impatrq/ARES/Hardware/PCB/Placa_filtro/Filtro_3D.png

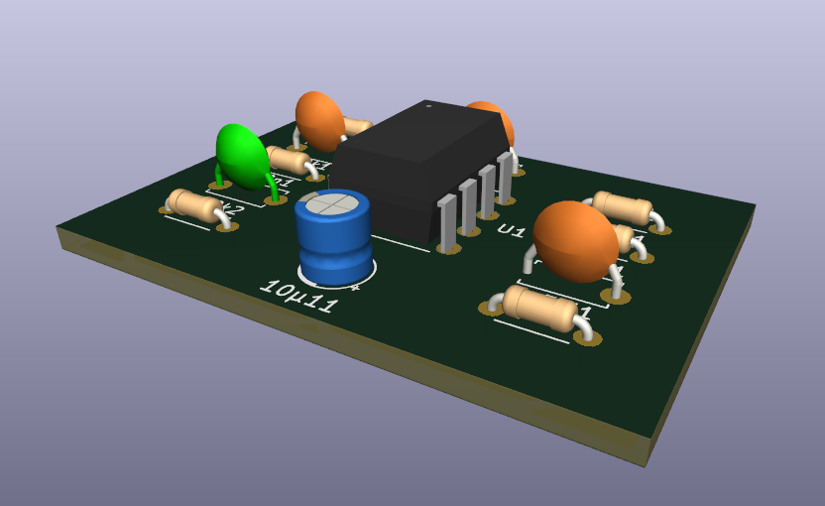
Hardware/PCB/Placa_filtro/Filtro_3D.png
