impatrq/ARES/Hardware/PCB/Placa_prototipo/Placa_prototipo.png

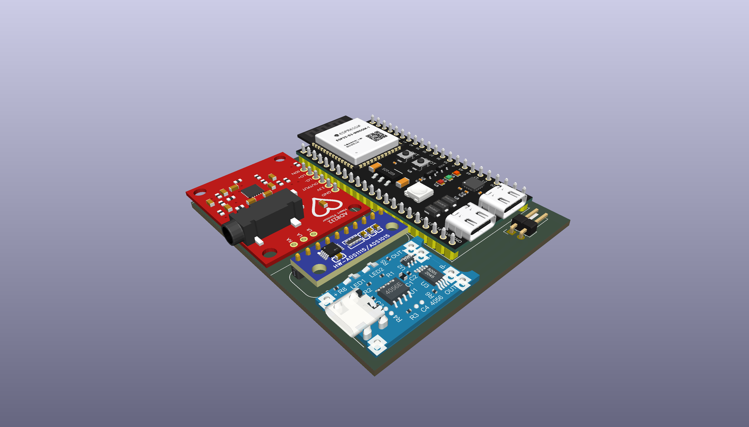
Hardware/PCB/Placa_prototipo/Placa_prototipo.png
