impatrq/ARES/Hardware/Diseño_3D/Diseño_Preliminar/Diseño_Preliminar.png

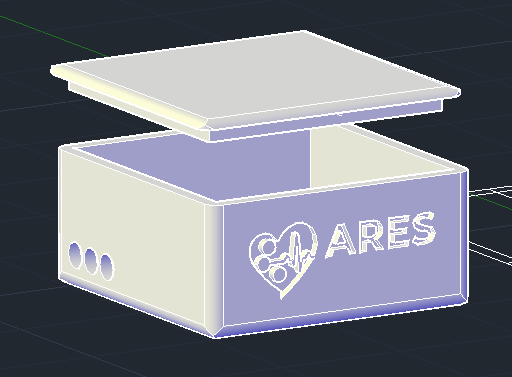
Hardware/Diseño_3D/Diseño_Preliminar/Diseño_Preliminar.png
