impatrq/ARES/Hardware/PCB/Placa_filtro/Placa_3D.png

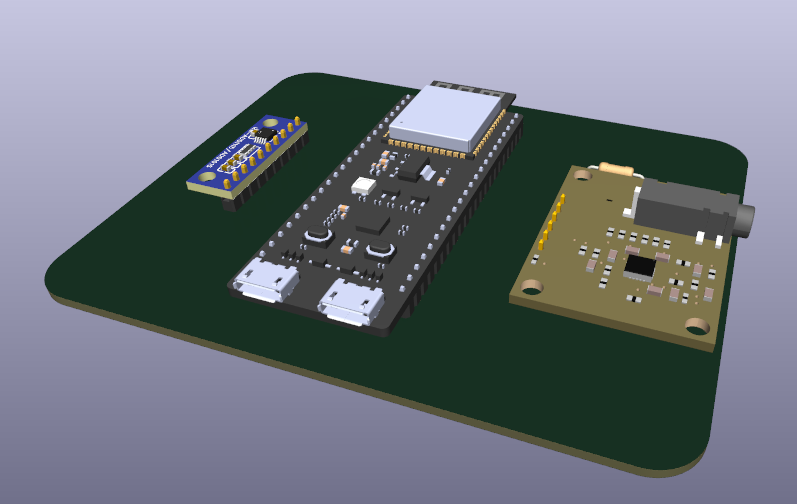
Hardware/PCB/Placa_filtro/Placa_3D.png
