impatrq/ARES/Hardware/PCB/Placa_filtro/Placa_Filtro.png

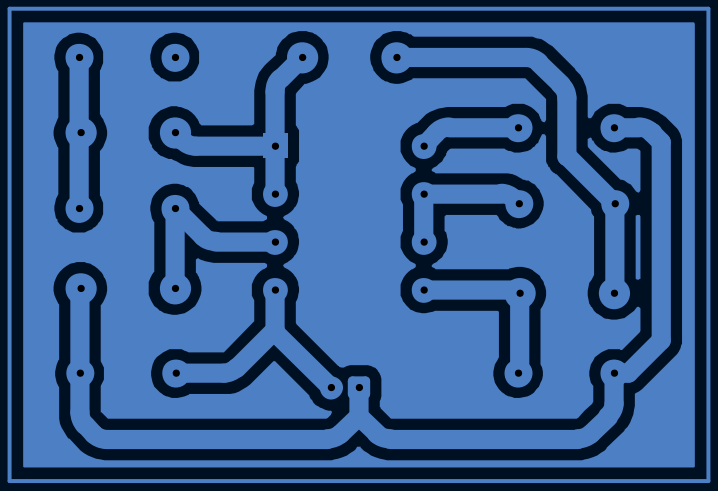
Hardware/PCB/Placa_filtro/Placa_Filtro.png
