impatrq/ARES/Simulaciones/Filtros/circuito filtros.jpeg

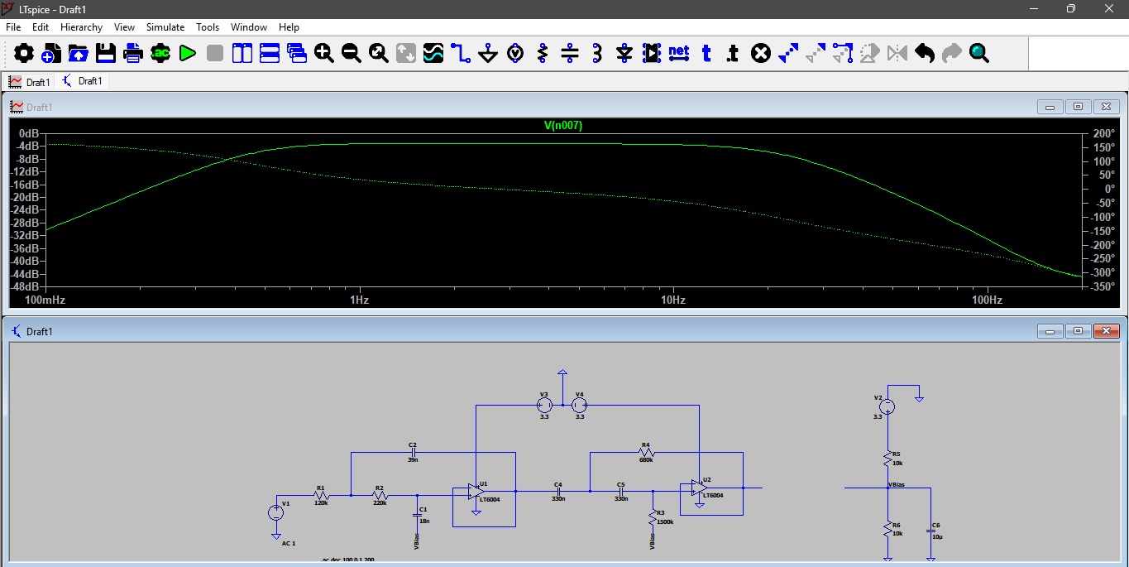
Simulaciones/Filtros/circuito filtros.jpeg
