impatrq/ARES/Web/web_vieja/src/assets/device-mockup.jpg

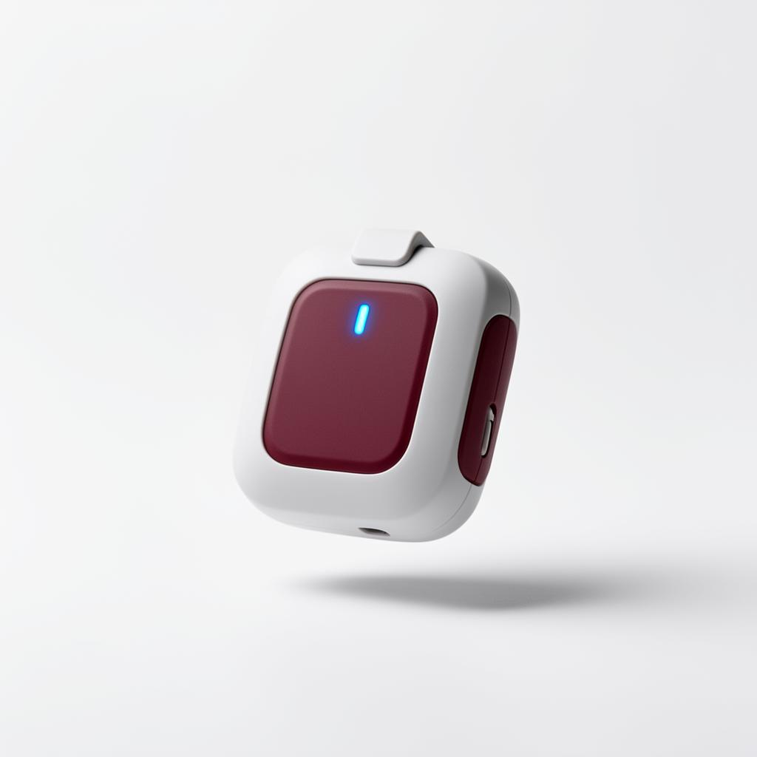
Web/web_vieja/src/assets/device-mockup.jpg
