impatrq/ARES/Web/web_vieja/src/assets/hero-bg.jpg

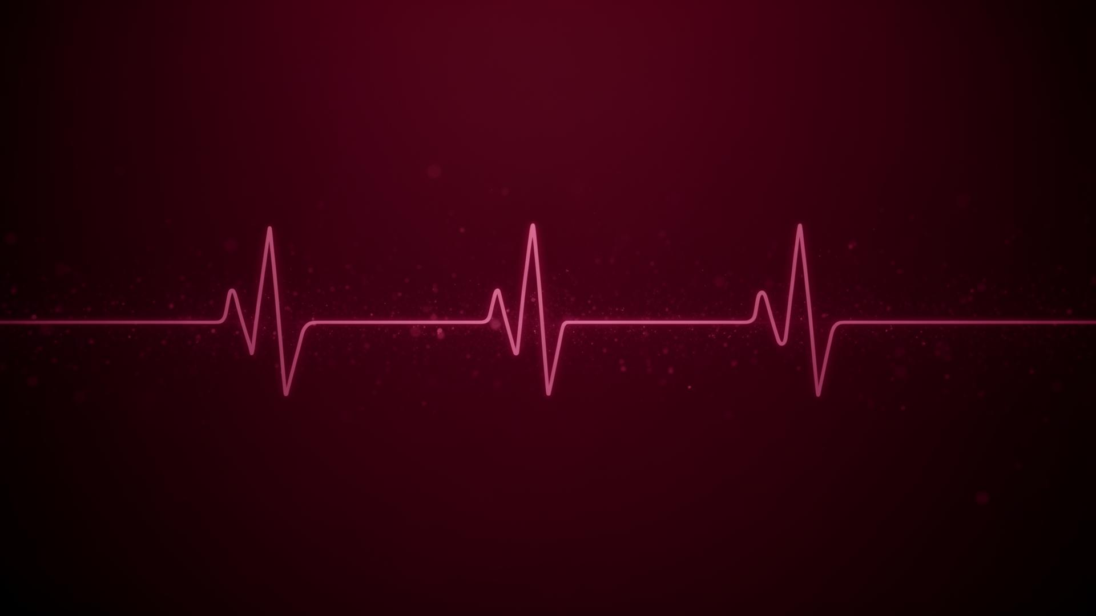
Web/web_vieja/src/assets/hero-bg.jpg
