impatrq/ARES/Hardware/Componentes/AD8232/AD8232_IC.jpg

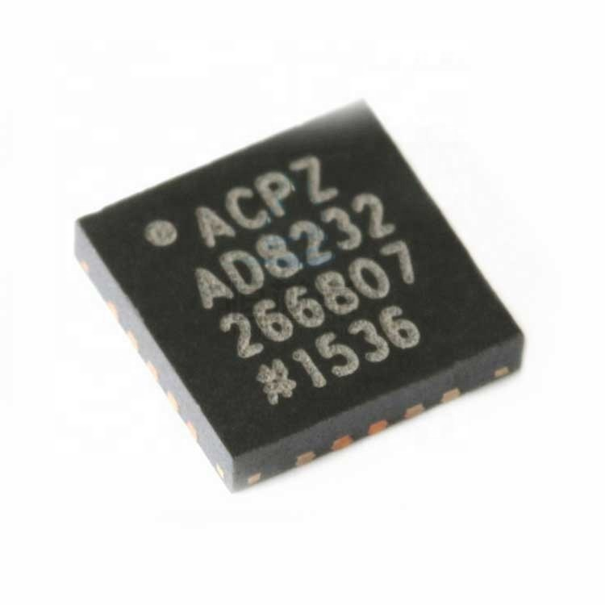
Hardware/Componentes/AD8232/AD8232_IC.jpg
