impatrq/ARES/Hardware/Componentes/AD8232/AD8232_modulo.jpg

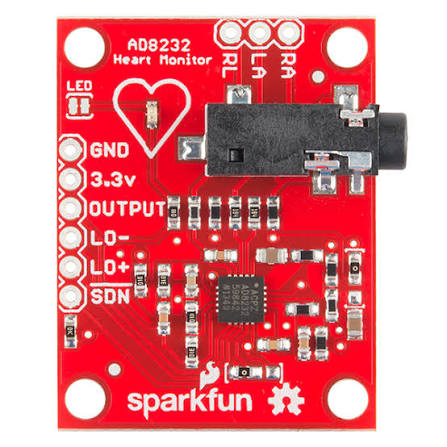
Hardware/Componentes/AD8232/AD8232_modulo.jpg
