impatrq/ARES/Hardware/Componentes/ADS1115/ADS1115_IC.png

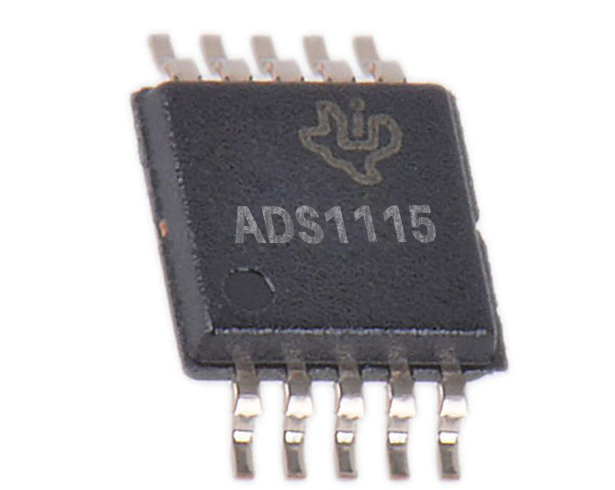
Hardware/Componentes/ADS1115/ADS1115_IC.png
