impatrq/ARES/Hardware/Componentes/ADS1115/ADS1115_modulo.jpg

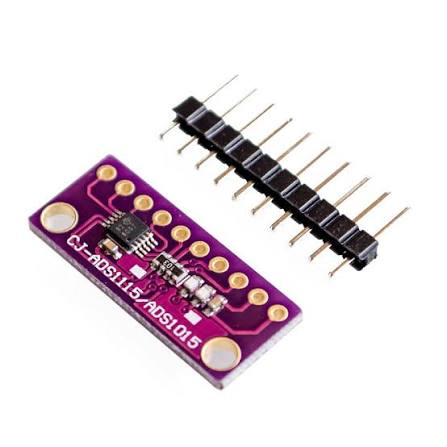
Hardware/Componentes/ADS1115/ADS1115_modulo.jpg
