impatrq/ARES/Hardware/Componentes/ESP32-S3/ESP32_S3_devkit.png

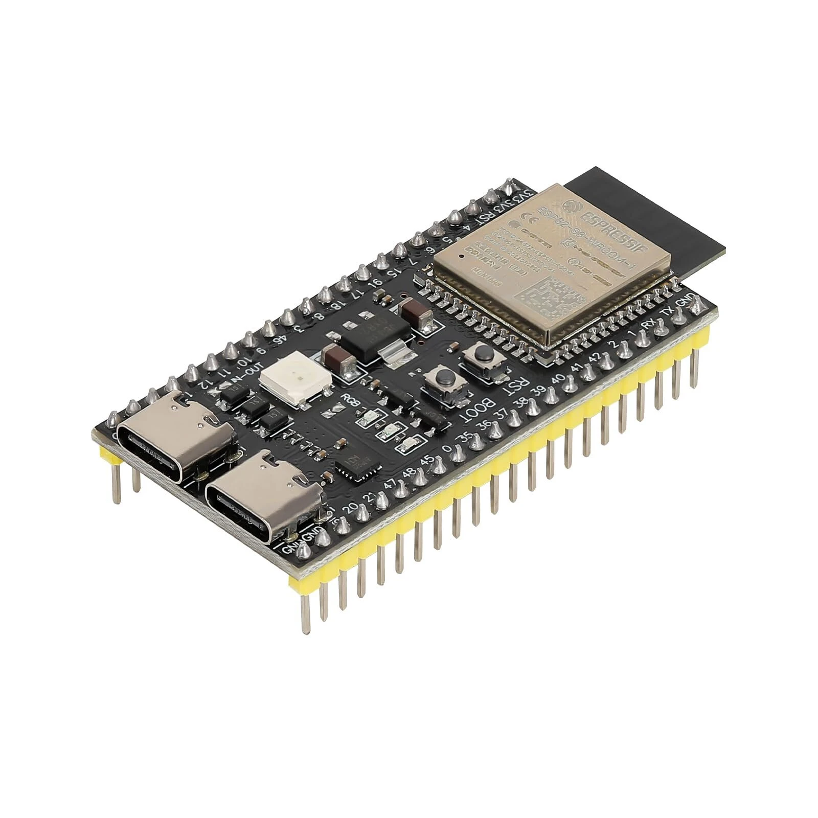
Hardware/Componentes/ESP32-S3/ESP32_S3_devkit.png
