impatrq/ARES/Hardware/Componentes/ESP32-S3/ESP32_S3_wroom.jpg

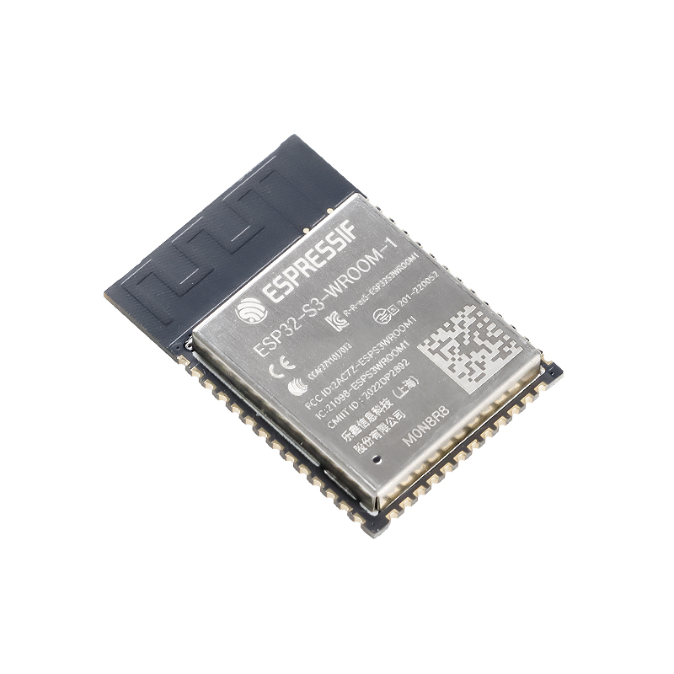
Hardware/Componentes/ESP32-S3/ESP32_S3_wroom.jpg
