impatrq/ARES/Hardware/Componentes/TP4056/TP4056_IC.jpg

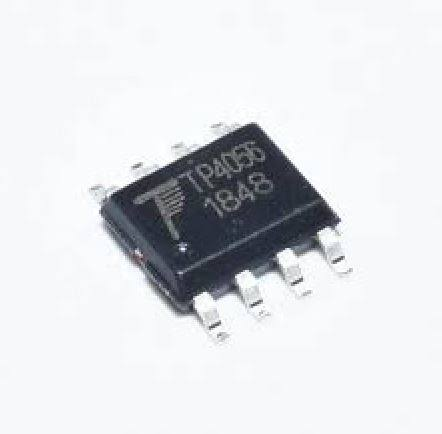
Hardware/Componentes/TP4056/TP4056_IC.jpg
