impatrq/ARES/Hardware/Componentes/TP4056/TP4056_modulo.png

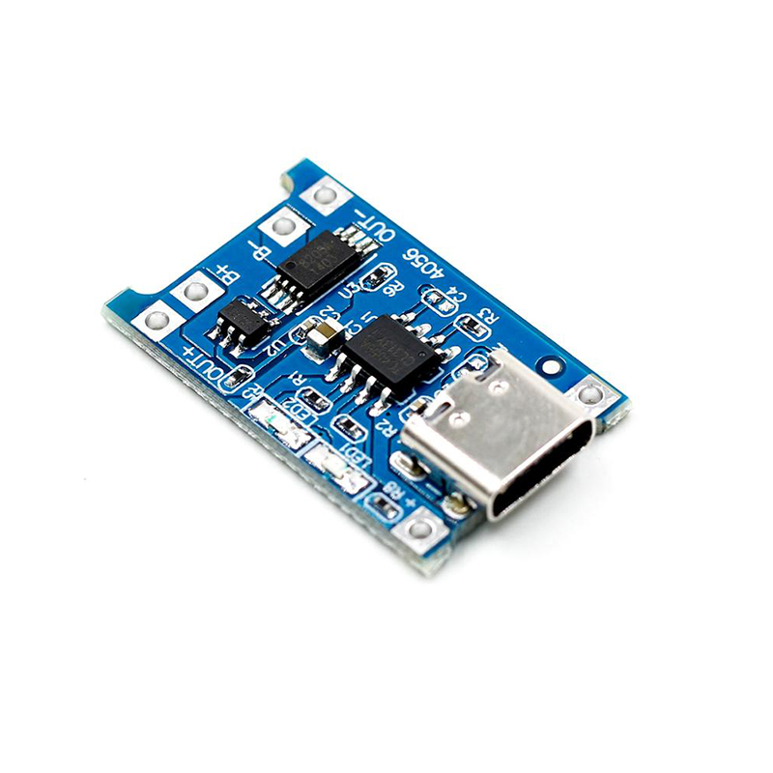
Hardware/Componentes/TP4056/TP4056_modulo.png
