impatrq/ARES/(list of files, cad)

Other CAD files:
Hardware/Diseño_3D/Diseño_Preliminar/Diseño_Preliminar_ARES.dwg
