impatrq/ARES/Hardware/PCB/Placa_de_prueba/Placa_de_prueba.png

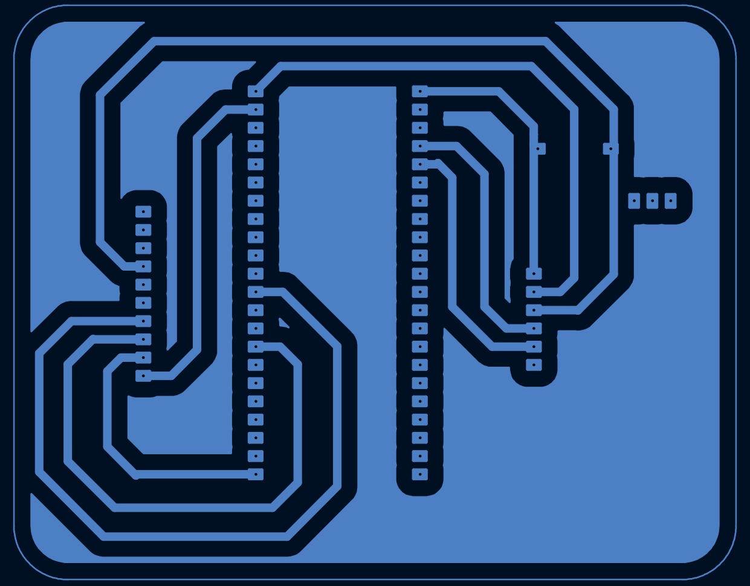
Hardware/PCB/Placa_de_prueba/Placa_de_prueba.png
