impatrq/ARES/Simulaciones/Filtros/Filtro Pasabanda Analogico ARES.asc

C1: cap; 18n
C2: cap; 39n
C4: cap; 330n
C5: cap; 330n
C6: cap; 10µ
R1: res; 120k
R2: res; 220k
R3: res; 1500k
R4: res; 680k
R5: res; 10k
R6: res; 10k
U1: LT6004
U2: LT6004
V1: voltage; ""; AC 1
V2: voltage; 3.3
V3: voltage; 3.3
V4: voltage; 3.3
Named nets: 0, VBias
.ac dec 100 0.1 200
.tran 200m
