impatrq/ARES/Hardware/PCB/Placa_de_prueba/Placa_de_prueba.kicad_pcb

## KiCad design Hardware/PCB/Placa_de_prueba/Placa_de_prueba.kicad_pcb (2026-08-30)

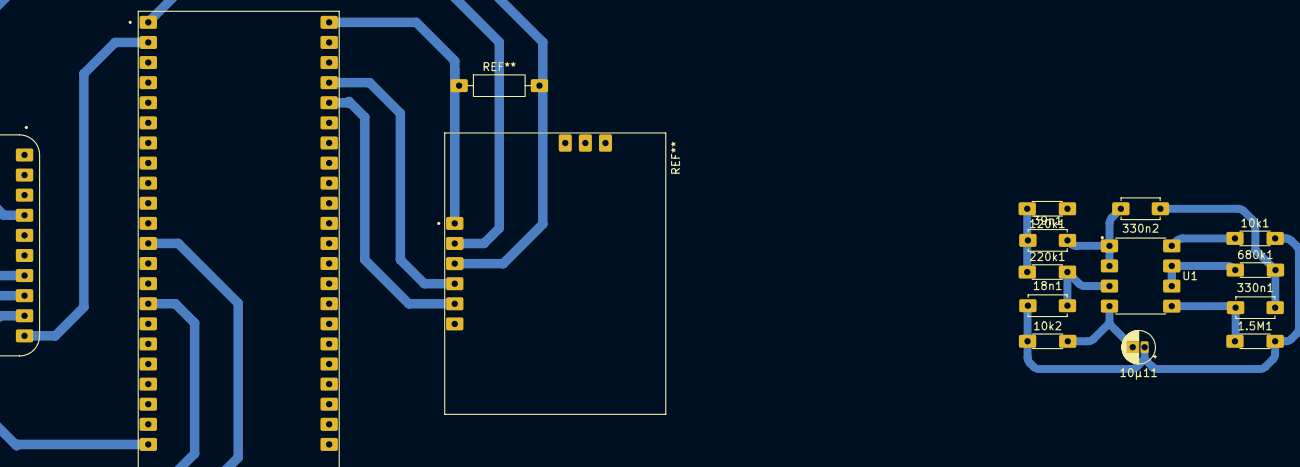
[picture p18: board Placa_de_prueba.kicad_pcb from above]

Board: 2 copper layers, 12 parts (0 on the bottom side), 9 nets.

Parts:
1.5M1, 10k1, 10k2, 120k1, 220k1, 680k1: R; R_Axial_DIN0204_L3.6mm_D1.6mm_P5.08mm_Horizontal
10µ11: C; CP_Radial_D4.0mm_P1.50mm
18n1, 39n1, 330n1, 330n2: C; C_Disc_D4.7mm_W2.5mm_P5.00mm
U1: MCP6002-I_P; DIP787W46P254L927H533Q8

Connections:
3.3v: 10k1.1, U1.8 (VDD)
A: 1.5M1.2, 10k1.2, 10k2.1, 10µ11.1, 18n1.1
GND: 10k2.2, 10µ11.2, U1.4 (VSS)
unnamed: 39n1.1, 120k1.2, 220k1.1
unnamed: 330n1.2, 330n2.1, 680k1.2
unnamed: 18n1.2, 220k1.2, U1.3 (VINA+)
unnamed: 39n1.2, 330n2.2, U1.1 (VOUTA), U1.2 (VINA-)
unnamed: 1.5M1.1, 330n1.1, U1.5 (VINB+)
unnamed: 680k1.1, U1.6 (VINB-), U1.7 (VOUTB)
