impatrq/ARES/(commit log)

2026-04-08 cargo el antreproyecto al repositorio
2026-06-10 Feat: Agrego simulacion de filtros
2026-06-10 Feat: Imagen del circuito
2026-08-26 feat(web): agregar primera version de la web
2026-08-26 feat(ia): agregar los resultados del entrenamiento de la IA
2026-08-30 feat(pcb): agregar la placa del filtro
    [.kicad_sch, .kicad_sch.kicad_sch, Placa_filtro.kicad_pcb, Placa_filtro.kicad_sch]
2026-08-30 feat: agregar imagen de ESP32 S3
2026-08-30 feat(pcb): agregar la placa de pruebas
    [Placa_de_prueba-job.gbrjob]
2026-08-30 feat(pcb): agregar imagen de la placa de prueba
2026-09-04 feat: agregar historias de usuario
2026-09-04 feat(3D): agregar diseño 3D preliminar
    [Diseño_Preliminar_ARES.dwg]
2026-10-06 fix(codigo): Modifico codigo anterior por WIFI
    [main.cpp]
2026-11-06 feat(pcb): agregar archivo pcb
2026-11-06 feat(pcb): agregar esquemático de la placa
2026-11-06 feat(pcb): agregar equemático de la placa
2026-11-06 feat(pcb): agregar gerber de la placa
2026-11-06 feat(pcb): agregar archivo .ngc para la cnc
2026-11-06 feat(pcb): agregar backups del proyecto kicad
2026-11-06 feat(pcb): agregar .gbrjob
2026-11-06 feat(pcb): agregar pcb kicad
2026-11-06 feat(pcb): agregar archivo prl
2026-11-06 feat(pcb): agregar proyecto kicad
2026-11-06 feat(pcb): agregar esquemático
2026-11-06 feat(pcb): agregar archivo del usuario
2026-11-06 feat(pcb): agregar config para pcb2gcode
2026-11-06 feat(pcb): agregar imagen de la placa prototipo
